Morita-Daiki/MD_Rev_November/MD_RS555.pdf

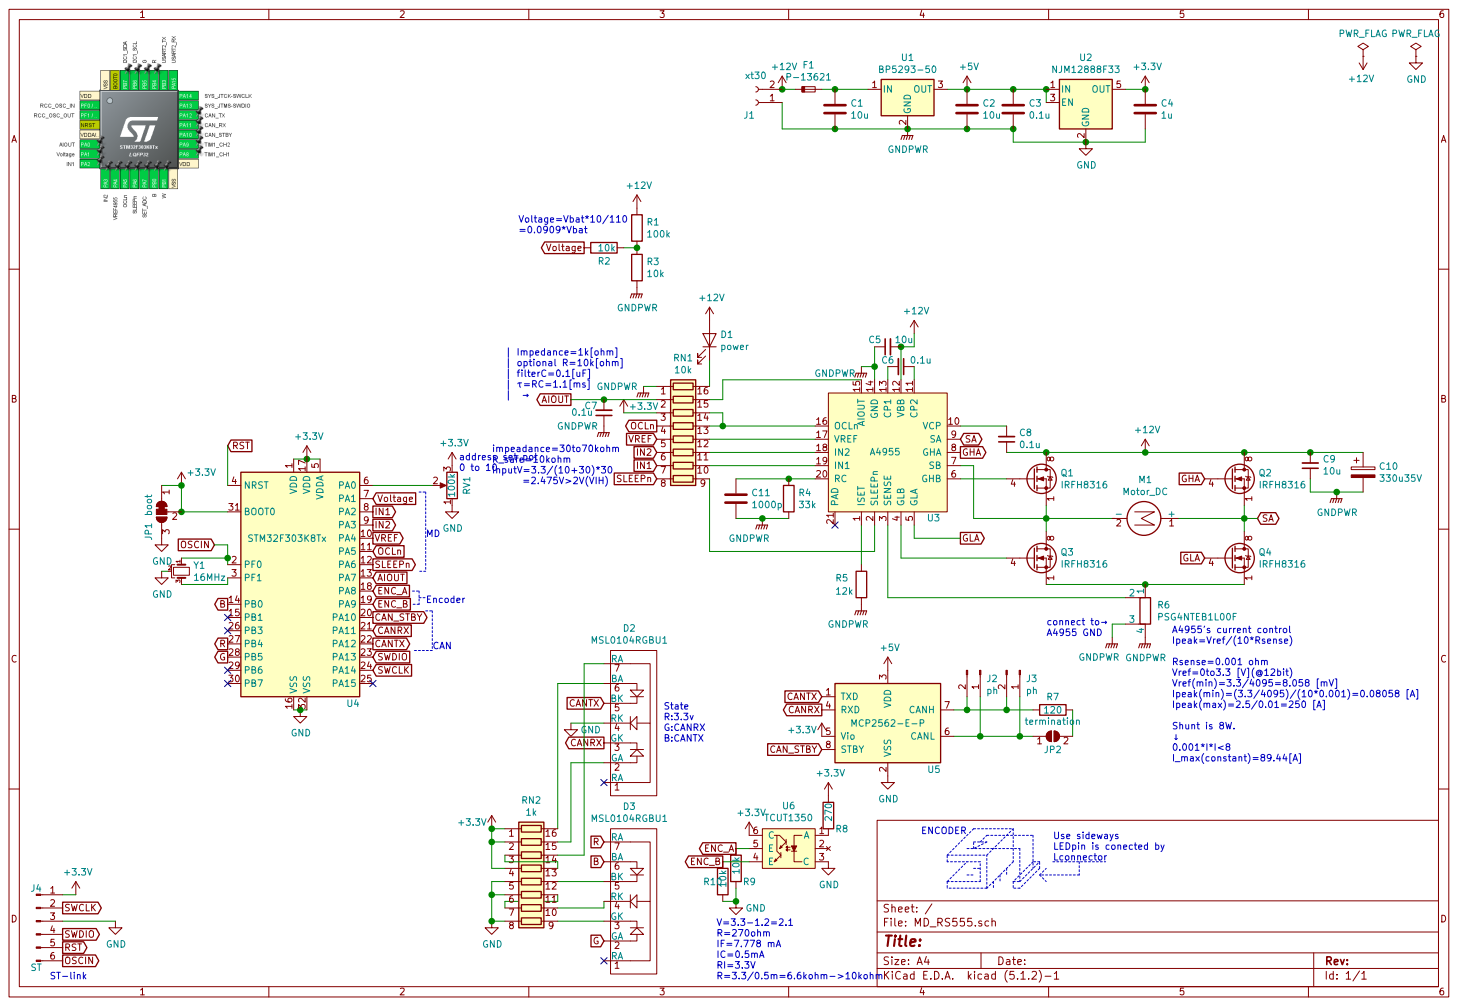
[picture p4: page 1]

1 VCP 10 CP2 11 VBB 12 CP1 13 GND 14 AIOUT 15 OCLn 16 VREF 17

5 GHB 6 SB 7 GHA 8 SA 9 U3 A4955

A4955's current control Ipeak=Vref/(10*Rsense) Rsense=0.001 ohm

Vref=0to3.3 [V](@12bit)
Vref(min)=3.3/4095=8.058 [mV]
Ipeak(min)=(3.3/4095)/(10*0.001)=0.08058 [A]
Ipeak(max)=2.5/0.01=250 [A] Shunt is 8W. 0.001*I*I<8

CANTX CANRX | | 5BA

3 RXD 4 Vio 5 CANL 6 CANH 7 STBY 8 U5 MCP2562-E-P

LEDpin is conected by Lconnector
