Morita-Daiki/MD_Rev_November/Core/Src/main.c

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

/* Includes ------------------------------------------------------------------*/
#include "main.h"
#include "adc.h"
#include "can.h"
#include "dac.h"
#include "dma.h"
#include "tim.h"
#include "gpio.h"


void SystemClock_Config(void);
/**
  * @brief  The application entry point.
  * @retval int
  */
int main(void)
{
  

  /* MCU Configuration--------------------------------------------------------*/

  /* Reset of all peripherals, Initializes the Flash interface and the Systick. */
  HAL_Init();

  /* Configure the system clock */
  SystemClock_Config();

  /* Initialize all configured peripherals */
  MX_GPIO_Init();
  MX_DMA_Init();
  MX_ADC1_Init();
  MX_ADC2_Init();
  MX_CAN_Init();
  MX_DAC1_Init();
  MX_TIM1_Init();
  MX_TIM3_Init();
  MX_TIM15_Init();
  /* USER CODE BEGIN 2 */
	DAC_Start();
	Encoder_Start();
	Pwm_Start();
	CAN_Start();
	ADC_Start();
  /* USER CODE END 2 */
 
 

  /* Infinite loop */
  /* USER CODE BEGIN WHILE */
	int counter = 0;
//	RGB_Set(1000, 0, 0);
//	HAL_Delay(1000);
//	RGB_Set(0, 1000, 0);
//	HAL_Delay(1000);
//	RGB_Set(0, 0, 1000);
//	HAL_Delay(1000);
//	RGB_Set(100, 0, 0);
//	HAL_Delay(1000);
//	RGB_Set(0, 100, 0);
//	HAL_Delay(1000);
//	RGB_Set(0, 0, 100);
//	HAL_Delay(1000);
	HAL_GPIO_WritePin(SLEEPn_GPIO_Port, SLEEPn_Pin, 1);
	HAL_GPIO_WritePin(CAN_STBY_GPIO_Port, CAN_STBY_Pin, 0);

	while (1) {
		int16_t cur = (RxData[ID * 2 - 2] << 8) + (RxData[ID * 2 - 1] << 0);
		double current = (double) cur;
		double current2 = 1023.0 - current / 0x7fff * 1023.0;
		if (current > 0.0)
			Pwm_Set(current2, 1023);
		else if (current < 0.0) {
			Pwm_Set(1023, -current2);
			current = -current;
		} else
			Pwm_Set(1023, 1023);
		DAC_set_voltage(2.5 * current / 0x7fff);
		int32_t enc_val = Encoder_Read();

		TxData[0] = (enc_val >> 24) & 0xff; //position32bit
		TxData[1] = (enc_val >> 16) & 0xff;
		TxData[2] = (enc_val >> 8) & 0xff;
		TxData[3] = (enc_val >> 0) & 0xff;

		TxData[4] = (ADCBuffer1[1] >> 8) & 0xff;//voltage
		TxData[5] = (ADCBuffer1[1] >> 0) & 0xff;

		TxData[6] = (ADCBuffer2[0] >> 8) & 0xff;//current
		TxData[7] = (ADCBuffer2[0] >> 0) & 0xff;

		ADCBuffer1;
		ADCBuffer2;
//		uint16_t voltage = ADCValue[0];
//		uint16_t aiout = ADCValue[1];
//		TxData[4] = (ADCValue[1] >> 8) & 0xff; //current
//		TxData[5] = (ADCValue[1] >> 0) & 0xff;
//
//		TxData[6] = (ADCValue[0] >> 8) & 0xff; //voltage
//		TxData[7] = (ADCValue[0] >> 0) & 0xff;
//		TxData[0]=0xAA;
//		TxData[1]=0xAB;
//		TxData[2]=0xA9;
//		TxData[3]=0xAA;
//		TxData[4]=0xAA;
//		TxData[5]=0xAB;
//		TxData[6]=0xAB;
//		TxData[7]=0xA9;

		CAN_Send();
//		RGB_Set(abs(enc_val), counter, 500);
		RGB_Set(RxData[0], RxData[1], RxData[2]);

		HAL_Delay(1);
		counter++;
    /* USER CODE END WHILE */

    /* USER CODE BEGIN 3 */
	}
  /* USER CODE END 3 */
}

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
