Morita-Daiki/MD_Rev_November/MD_Rev_November.ioc

Mcu.UserName=STM32F303K8Tx
PA0.GPIO_Label=RVIN
PA0.Signal=ADC1_IN1
PA1.GPIO_Label=Voltage
PA1.Signal=ADC1_IN2
PA10.GPIO_Label=CAN_STBY
PA10.Signal=GPIO_Output
PA11.Signal=CAN_RX
PA12.Signal=CAN_TX
PA13.Signal=SYS_JTMS-SWDIO
PA14.Signal=SYS_JTCK-SWCLK
PA2.GPIO_Label=IN1
PA2.Signal=S_TIM15_CH1
PA3.GPIO_Label=IN2
PA3.Signal=S_TIM15_CH2
PA4.GPIO_Label=VREF
PA4.Signal=COMP_DAC11_group
PA5.GPIO_Label=OCLn
PA5.Signal=GPIO_Input
PA6.GPIO_Label=SLEEPn
PA6.Signal=GPIO_Output
PA7.GPIO_Label=AIOUT
PA7.Signal=ADC2_IN4
PA8.GPIO_Label=ENC_A
PA8.Signal=S_TIM1_CH1
PA9.GPIO_Label=ENC_B
PA9.Signal=S_TIM1_CH2
PB0.GPIO_Label=Blue
PB0.Signal=S_TIM3_CH3
PB4.GPIO_Label=Red
PB4.Signal=S_TIM3_CH1
PB5.GPIO_Label=Green
PB5.Signal=S_TIM3_CH2
