Morita-Daiki/MD_Rev_November/Core/Inc/main.h

#define RVIN_Pin GPIO_PIN_0
#define RVIN_GPIO_Port GPIOA
#define Voltage_Pin GPIO_PIN_1
#define Voltage_GPIO_Port GPIOA
#define IN1_Pin GPIO_PIN_2
#define IN1_GPIO_Port GPIOA
#define IN2_Pin GPIO_PIN_3
#define IN2_GPIO_Port GPIOA
#define VREF_Pin GPIO_PIN_4
#define VREF_GPIO_Port GPIOA
#define OCLn_Pin GPIO_PIN_5
#define OCLn_GPIO_Port GPIOA
#define SLEEPn_Pin GPIO_PIN_6
#define SLEEPn_GPIO_Port GPIOA
#define AIOUT_Pin GPIO_PIN_7
#define AIOUT_GPIO_Port GPIOA
#define Blue_Pin GPIO_PIN_0
#define Blue_GPIO_Port GPIOB
#define ENC_A_Pin GPIO_PIN_8
#define ENC_A_GPIO_Port GPIOA
#define ENC_B_Pin GPIO_PIN_9
#define ENC_B_GPIO_Port GPIOA
#define CAN_STBY_Pin GPIO_PIN_10
#define CAN_STBY_GPIO_Port GPIOA
#define Red_Pin GPIO_PIN_4
#define Red_GPIO_Port GPIOB
#define Green_Pin GPIO_PIN_5
#define Green_GPIO_Port GPIOB
