Morita-Daiki/MD_Rev_November/Core/Src/tim.c

/**
  ******************************************************************************
  * File Name          : TIM.c
  * Description        : This file provides code for the configuration
  *                      of the TIM instances.
  ******************************************************************************
  * @attention
  *
  * <h2><center>&copy; Copyright (c) 2020 STMicroelectronics.
  * All rights reserved.</center></h2>
  *
  * This software component is licensed by ST under BSD 3-Clause license,
  * the "License"; You may not use this file except in compliance with the
  * License. You may obtain a copy of the License at:
  *                        opensource.org/licenses/BSD-3-Clause
  *
  ******************************************************************************
  */

/* Includes ------------------------------------------------------------------*/
#include "tim.h"

/* USER CODE BEGIN 0 */
TIM_Encoder_InitTypeDef sConfig = { 0 };
TIM_MasterConfigTypeDef sMasterConfig = { 0 };
TIM_OC_InitTypeDef sConfigOC = { 0 };
/* USER CODE END 0 */

TIM_HandleTypeDef htim1;
TIM_HandleTypeDef htim3;
TIM_HandleTypeDef htim15;

/* TIM1 init function */
void MX_TIM1_Init(void)
{
//  TIM_Encoder_InitTypeDef sConfig = {0};
//  TIM_MasterConfigTypeDef sMasterConfig = {0};

  htim1.Instance = TIM1;
  htim1.Init.Prescaler = 0;
  htim1.Init.CounterMode = TIM_COUNTERMODE_UP;
  htim1.Init.Period = 65535;
  htim1.Init.ClockDivision = TIM_CLOCKDIVISION_DIV1;
  htim1.Init.RepetitionCounter = 0;
  htim1.Init.AutoReloadPreload = TIM_AUTORELOAD_PRELOAD_DISABLE;
  sConfig.EncoderMode = TIM_ENCODERMODE_TI12;
  sConfig.IC1Polarity = TIM_ICPOLARITY_FALLING;
  sConfig.IC1Selection = TIM_ICSELECTION_DIRECTTI;
  sConfig.IC1Prescaler = TIM_ICPSC_DIV1;
  sConfig.IC1Filter = 3;
  sConfig.IC2Polarity = TIM_ICPOLARITY_FALLING;
  sConfig.IC2Selection = TIM_ICSELECTION_DIRECTTI;
  sConfig.IC2Prescaler = TIM_ICPSC_DIV1;
  sConfig.IC2Filter = 3;
  if (HAL_TIM_Encoder_Init(&htim1, &sConfig) != HAL_OK)
  {
    Error_Handler();
  }
  sMasterConfig.MasterOutputTrigger = TIM_TRGO_RESET;
  sMasterConfig.MasterOutputTrigger2 = TIM_TRGO2_RESET;
  sMasterConfig.MasterSlaveMode = TIM_MASTERSLAVEMODE_DISABLE;
  if (HAL_TIMEx_MasterConfigSynchronization(&htim1, &sMasterConfig) != HAL_OK)
  {
    Error_Handler();
  }

}
/* TIM3 init function */
void MX_TIM3_Init(void)
{
//  TIM_MasterConfigTypeDef sMasterConfig = {0};
//  TIM_OC_InitTypeDef sConfigOC = {0};

  htim3.Instance = TIM3;
  htim3.Init.Prescaler = 72-1;
  htim3.Init.CounterMode = TIM_COUNTERMODE_UP;
  htim3.Init.Period = 1023;
  htim3.Init.ClockDivision = TIM_CLOCKDIVISION_DIV1;
  htim3.Init.AutoReloadPreload = TIM_AUTORELOAD_PRELOAD_DISABLE;
  if (HAL_TIM_PWM_Init(&htim3) != HAL_OK)
  {
    Error_Handler();
  }
  sMasterConfig.MasterOutputTrigger = TIM_TRGO_RESET;
  sMasterConfig.MasterSlaveMode = TIM_MASTERSLAVEMODE_DISABLE;
  if (HAL_TIMEx_MasterConfigSynchronization(&htim3, &sMasterConfig) != HAL_OK)
  {
    Error_Handler();
  }
  sConfigOC.OCMode = TIM_OCMODE_PWM1;
  sConfigOC.Pulse = 0;
  sConfigOC.OCPolarity = TIM_OCPOLARITY_HIGH;
  sConfigOC.OCFastMode = TIM_OCFAST_DISABLE;
  if (HAL_TIM_PWM_ConfigChannel(&htim3, &sConfigOC, TIM_CHANNEL_1) != HAL_OK)
  {
    Error_Handler();
  }
  if (HAL_TIM_PWM_ConfigChannel(&htim3, &sConfigOC, TIM_CHANNEL_2) != HAL_OK)
  {
    Error_Handler();
  }
  if (HAL_TIM_PWM_ConfigChannel(&htim3, &sConfigOC, TIM_CHANNEL_3) != HAL_OK)
  {
    Error_Handler();
  }
  HAL_TIM_MspPostInit(&htim3);

}
/* TIM15 init function */
void MX_TIM15_Init(void)
{
//  TIM_MasterConfigTypeDef sMasterConfig = {0};
//  TIM_OC_InitTypeDef sConfigOC = {0};
  TIM_BreakDeadTimeConfigTypeDef sBreakDeadTimeConfig = {0};

  htim15.Instance = TIM15;
  htim15.Init.Prescaler = 2-1;
  htim15.Init.CounterMode = TIM_COUNTERMODE_UP;
  htim15.Init.Period = 1023;
  htim15.Init.ClockDivision = TIM_CLOCKDIVISION_DIV1;
  htim15.Init.RepetitionCounter = 0;
  htim15.Init.AutoReloadPreload = TIM_AUTORELOAD_PRELOAD_DISABLE;
  if (HAL_TIM_PWM_Init(&htim15) != HAL_OK)
  {
    Error_Handler();
  }
  sMasterConfig.MasterOutputTrigger = TIM_TRGO_RESET;
  sMasterConfig.MasterSlaveMode = TIM_MASTERSLAVEMODE_DISABLE;
  if (HAL_TIMEx_MasterConfigSynchronization(&htim15, &sMasterConfig) != HAL_OK)
  {
    Error_Handler();
  }
  sConfigOC.OCMode = TIM_OCMODE_PWM1;
  sConfigOC.Pulse = 0;
  sConfigOC.OCPolarity = TIM_OCPOLARITY_HIGH;
  sConfigOC.OCNPolarity = TIM_OCNPOLARITY_HIGH;
  sConfigOC.OCFastMode = TIM_OCFAST_DISABLE;
  sConfigOC.OCIdleState = TIM_OCIDLESTATE_RESET;
  sConfigOC.OCNIdleState = TIM_OCNIDLESTATE_RESET;
  if (HAL_TIM_PWM_ConfigChannel(&htim15, &sConfigOC, TIM_CHANNEL_1) != HAL_OK)
  {
    Error_Handler();
  }
  if (HAL_TIM_PWM_ConfigChannel(&htim15, &sConfigOC, TIM_CHANNEL_2) != HAL_OK)
  {
    Error_Handler();
  }
  sBreakDeadTimeConfig.OffStateRunMode = TIM_OSSR_DISABLE;
  sBreakDeadTimeConfig.OffStateIDLEMode = TIM_OSSI_DISABLE;
  sBreakDeadTimeConfig.LockLevel = TIM_LOCKLEVEL_OFF;
  sBreakDeadTimeConfig.DeadTime = 0;
  sBreakDeadTimeConfig.BreakState = TIM_BREAK_DISABLE;
  sBreakDeadTimeConfig.BreakPolarity = TIM_BREAKPOLARITY_HIGH;
  sBreakDeadTimeConfig.BreakFilter = 0;
  sBreakDeadTimeConfig.AutomaticOutput = TIM_AUTOMATICOUTPUT_DISABLE;
  if (HAL_TIMEx_ConfigBreakDeadTime(&htim15, &sBreakDeadTimeConfig) != HAL_OK)
  {
    Error_Handler();
  }
  HAL_TIM_MspPostInit(&htim15);

}

void HAL_TIM_Encoder_MspInit(TIM_HandleTypeDef* tim_encoderHandle)
{

  GPIO_InitTypeDef GPIO_InitStruct = {0};
  if(tim_encoderHandle->Instance==TIM1)
  {
    /* TIM1 clock enable */
    __HAL_RCC_TIM1_CLK_ENABLE();
  
    __HAL_RCC_GPIOA_CLK_ENABLE();
    /**TIM1 GPIO Configuration    
    PA8     ------> TIM1_CH1
    PA9     ------> TIM1_CH2 
    */
    GPIO_InitStruct.Pin = ENC_A_Pin|ENC_B_Pin;
    GPIO_InitStruct.Mode = GPIO_MODE_AF_PP;
    GPIO_InitStruct.Pull = GPIO_NOPULL;
    GPIO_InitStruct.Speed = GPIO_SPEED_FREQ_LOW;
    GPIO_InitStruct.Alternate = GPIO_AF6_TIM1;
    HAL_GPIO_Init(GPIOA, &GPIO_InitStruct);

  }
}

void HAL_TIM_PWM_MspInit(TIM_HandleTypeDef* tim_pwmHandle)
{

  if(tim_pwmHandle->Instance==TIM3)
  {
    /* TIM3 clock enable */
    __HAL_RCC_TIM3_CLK_ENABLE();
  }
  else if(tim_pwmHandle->Instance==TIM15)
  {
    /* TIM15 clock enable */
    __HAL_RCC_TIM15_CLK_ENABLE();
  }
}
void HAL_TIM_MspPostInit(TIM_HandleTypeDef* timHandle)
{

  GPIO_InitTypeDef GPIO_InitStruct = {0};
  if(timHandle->Instance==TIM3)
  {
    __HAL_RCC_GPIOB_CLK_ENABLE();
    /**TIM3 GPIO Configuration    
    PB0     ------> TIM3_CH3
    PB4     ------> TIM3_CH1
    PB5     ------> TIM3_CH2 
    */
    GPIO_InitStruct.Pin = Blue_Pin|Red_Pin|Green_Pin;
    GPIO_InitStruct.Mode = GPIO_MODE_AF_PP;
    GPIO_InitStruct.Pull = GPIO_NOPULL;
    GPIO_InitStruct.Speed = GPIO_SPEED_FREQ_LOW;
    GPIO_InitStruct.Alternate = GPIO_AF2_TIM3;
    HAL_GPIO_Init(GPIOB, &GPIO_InitStruct);

  }
  else if(timHandle->Instance==TIM15)
  {
  
    __HAL_RCC_GPIOA_CLK_ENABLE();
    /**TIM15 GPIO Configuration    
    PA2     ------> TIM15_CH1
    PA3     ------> TIM15_CH2 
    */
    GPIO_InitStruct.Pin = IN1_Pin|IN2_Pin;
    GPIO_InitStruct.Mode = GPIO_MODE_AF_PP;
    GPIO_InitStruct.Pull = GPIO_NOPULL;
    GPIO_InitStruct.Speed = GPIO_SPEED_FREQ_LOW;
    GPIO_InitStruct.Alternate = GPIO_AF9_TIM15;
    HAL_GPIO_Init(GPIOA, &GPIO_InitStruct);

  }

}

void HAL_TIM_Encoder_MspDeInit(TIM_HandleTypeDef* tim_encoderHandle)
{

  if(tim_encoderHandle->Instance==TIM1)
  {
    /* Peripheral clock disable */
    __HAL_RCC_TIM1_CLK_DISABLE();
  
    /**TIM1 GPIO Configuration    
    PA8     ------> TIM1_CH1
    PA9     ------> TIM1_CH2 
    */
    HAL_GPIO_DeInit(GPIOA, ENC_A_Pin|ENC_B_Pin);

  }
}

void HAL_TIM_PWM_MspDeInit(TIM_HandleTypeDef* tim_pwmHandle)
{

  if(tim_pwmHandle->Instance==TIM3)
  {
    /* Peripheral clock disable */
    __HAL_RCC_TIM3_CLK_DISABLE();
  }
  else if(tim_pwmHandle->Instance==TIM15)
  {
    /* Peripheral clock disable */
    __HAL_RCC_TIM15_CLK_DISABLE();
  }
} 

/* USER CODE BEGIN 1 */
void Encoder_Start(void) {
	if (HAL_TIM_Encoder_Init(&htim1, &sConfig) != HAL_OK) {
		Error_Handler();
	}
	HAL_TIM_Encoder_Start(&htim1, TIM_CHANNEL_ALL);
	TIM1->CNT = 30000;
}
void Pwm_Start(void) {
	if (HAL_TIM_PWM_Start(&htim3, TIM_CHANNEL_1) != HAL_OK) {
		Error_Handler();
	}
	if (HAL_TIM_PWM_Start(&htim3, TIM_CHANNEL_2) != HAL_OK) {
		Error_Handler();
	}
	if (HAL_TIM_PWM_Start(&htim3, TIM_CHANNEL_3) != HAL_OK) {
		Error_Handler();
	}
	if (HAL_TIM_PWM_Start(&htim15, TIM_CHANNEL_1) != HAL_OK) {
		Error_Handler();
	}
	if (HAL_TIM_PWM_Start(&htim15, TIM_CHANNEL_2) != HAL_OK) {
		Error_Handler();
	}
}
void Pwm_Set(unsigned int in1, unsigned int in2) {
	__HAL_TIM_SET_COMPARE(&htim15, TIM_CHANNEL_1, in1);
	__HAL_TIM_SET_COMPARE(&htim15, TIM_CHANNEL_2, in2);
}
void RGB_Set(unsigned int r, unsigned int g, unsigned int b) {
	__HAL_TIM_SET_COMPARE(&htim3, TIM_CHANNEL_1, r);
	__HAL_TIM_SET_COMPARE(&htim3, TIM_CHANNEL_2, g);
	__HAL_TIM_SET_COMPARE(&htim3, TIM_CHANNEL_3, b);

}
int32_t Encoder_Read(void) {
	static int32_t val;
	int dcnt = (TIM1->CNT) - 30000;
	val += dcnt;
	TIM1->CNT -= dcnt;
	return val;
}
/* USER CODE END 1 */

/************************ (C) COPYRIGHT STMicroelectronics *****END OF FILE****/
