Morita-Daiki/MD_Rev_November/Core/Inc/can.h

/**
  ******************************************************************************
  * File Name          : CAN.h
  * Description        : This file provides code for the configuration
  *                      of the CAN instances.
  ******************************************************************************
  * @attention
  *
  * <h2><center>&copy; Copyright (c) 2020 STMicroelectronics.
  * All rights reserved.</center></h2>
  *
  * This software component is licensed by ST under BSD 3-Clause license,
  * the "License"; You may not use this file except in compliance with the
  * License. You may obtain a copy of the License at:
  *                        opensource.org/licenses/BSD-3-Clause
  *
  ******************************************************************************
  */
/* Define to prevent recursive inclusion -------------------------------------*/
#ifndef __can_H
#define __can_H
#ifdef __cplusplus
 extern "C" {
#endif

/* Includes ------------------------------------------------------------------*/
#include "main.h"

extern CAN_HandleTypeDef hcan;

/* USER CODE BEGIN Private defines */
extern CAN_TxHeaderTypeDef TxHeader;
extern CAN_RxHeaderTypeDef RxHeader;
#define ID 1
#define TXID (0x200+ID)
#define RXID ((ID <= 4) ? 0x200 : 0x1ff)

uint8_t TxData[8];
uint8_t RxData[8];
uint32_t TxMailbox;
uint8_t cnt;
/* USER CODE END Private defines */

void MX_CAN_Init(void);

/* USER CODE BEGIN Prototypes */
void CAN_Filter_Init(void);
void CAN_Start(void);
void HAL_CAN_RXFifo0MsgPendingCallback(CAN_HandleTypeDef *hcan);
void CAN_Send(void);
/* USER CODE END Prototypes */

#ifdef __cplusplus
}
#endif
#endif /*__ can_H */

/**
  * @}
  */

/**
  * @}
  */

/************************ (C) COPYRIGHT STMicroelectronics *****END OF FILE****/
