Morita-Daiki/MD_Rev_November/(commit log)

2020-02-18 デバッグ可能
2020-02-20 動作（送信のみ），受信がうまくいかない
2020-02-20 送受信大丈夫
2020-02-20 画像追加
2020-02-27 ADCうまくいかない
2020-02-27 pwm changeable
2020-02-28 一応完成
2020-02-28 解説追加
