Morita-Daiki/MD_Rev_November/(notices)

Notices in the files:
Core/Inc/main.h:
© Copyright (c) 2019 STMicroelectronics.
All rights reserved.
